pa3hcm/rigid-heddle-loom/print/pawl.stl

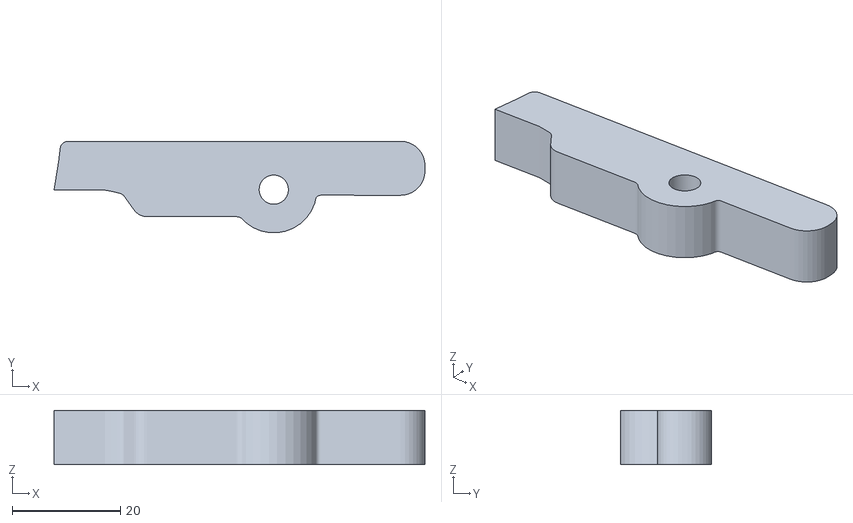
[picture p9: CAD file, 2026-11-07]
print/pawl.stl
68.7 x 16.9 x 10.0
