pa3hcm/rigid-heddle-loom/print/ratchet_front.stl

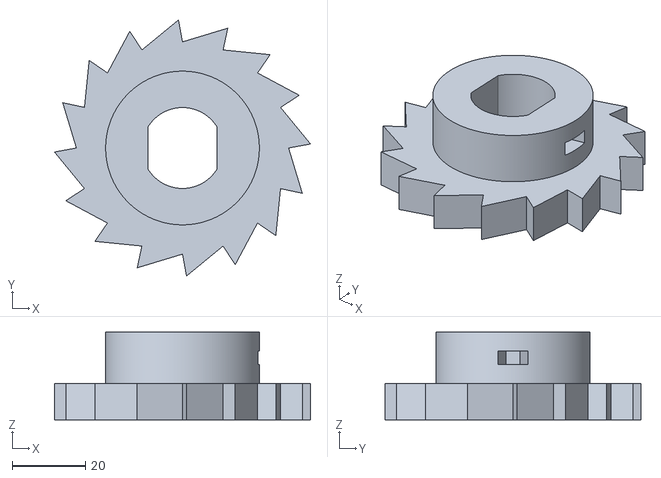
[picture p10: CAD file, 2026-11-05]
print/ratchet_front.stl
70.0 x 70.0 x 24.0
