pa3hcm/rigid-heddle-loom/print/filing_jig.stl

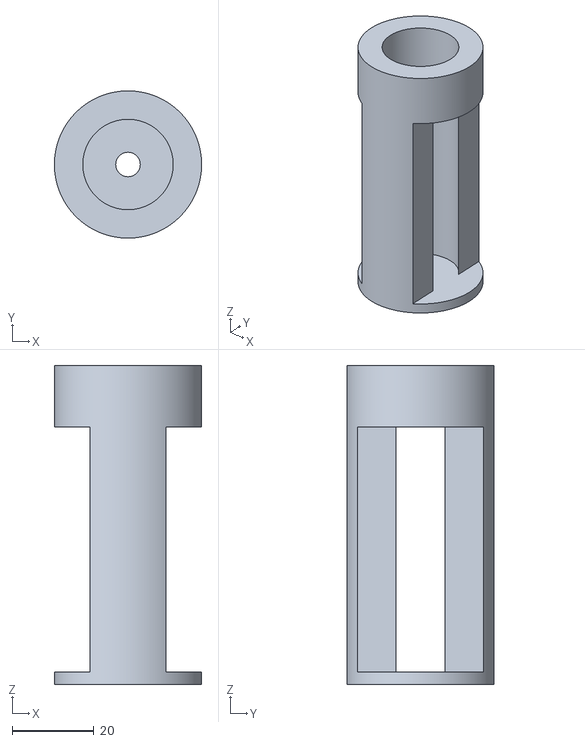
[picture p11: CAD file, 2026-11-05]
print/filing_jig.stl
36.0 x 36.0 x 78.0
