pa3hcm/rigid-heddle-loom/print/collar.stl

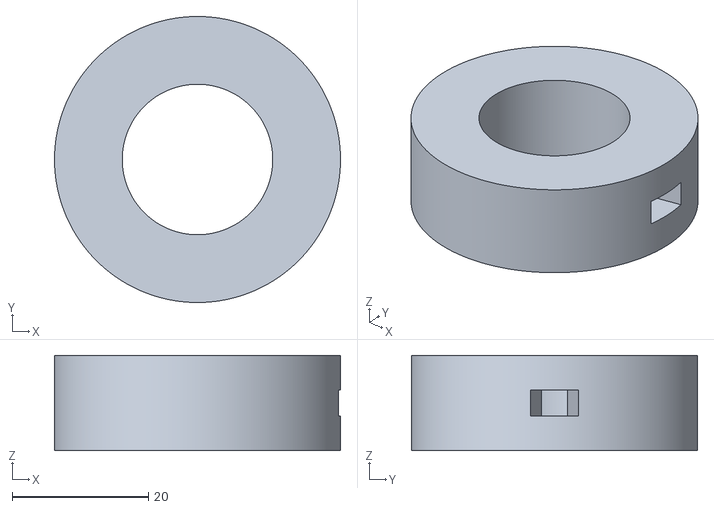
[picture p12: CAD file, 2026-11-05]
print/collar.stl
42.0 x 42.0 x 14.0
