pa3hcm/rigid-heddle-loom/print/knob.stl

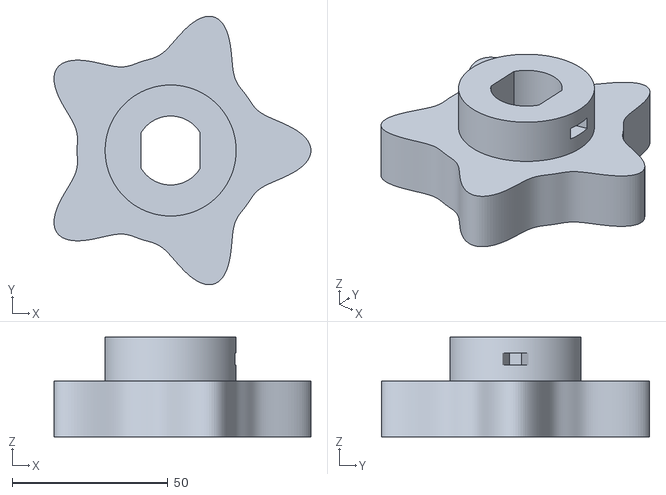
[picture p13: CAD file, 2026-11-05]
print/knob.stl
82.4 x 86.1 x 32.0
