pa3hcm/rigid-heddle-loom/print/loom_print.scad

// 3D-printed parts for the rigid heddle loom.
// Open in OpenSCAD, choose 'part' in the Customizer, F6 (render) and export as STL.
// Print settings: PETG or PLA, 0.2 mm layers, 4 walls, 40 % infill.
// You can also make print-ready STLs without OpenSCAD with generate_stl.py (same dimensions).

/* [Choice] */
part = "all"; // [all, ratchet_front, ratchet_back, pawl, knob, collar, filing_jig]

/* [Dimensions] */
dowel_d       = 21.7;  // diameter of the roller dowel (measured; nominal 22 mm)
clearance     = 0.4;   // extra bore for print tolerance
flat_distance = 18.5;  // distance between the two filed flats on the shaft
flat_length   = 60.0;  // length of the flats from the end of the shaft
screw_hole    = 3.8;   // locking hole for a 3.5 x 25 wood screw
teeth         = 16;
r_tip         = 35;    // outer radius of the ratchet wheel
r_root        = 29;    // root radius of the teeth
wheel_t       = 10;    // thickness of ratchet wheel = thickness of pawl
hub_d         = 42;
hub_l         = 14;
pawl_length   = 41;    // distance from pivot to pawl tip
pawl_hole     = 5.4;   // M5 pivot bolt
knob_d        = 90;
knob_t        = 18;
jig_d         = 36;    // outer diameter of the filing jig

$fn = 96;
bore = dowel_d + clearance;

module hub(l) {
    // hub with one radial locking hole in the +x direction (centred on a flat of the double-D bore)
    difference() {
        cylinder(d = hub_d, h = l);
        translate([0, 0, l / 2]) rotate([0, 90, 0]) cylinder(d = screw_hole, h = hub_d, $fn = 24);
    }
}

module double_d(h) {
    // bore for the filed shaft: round, with two flats perpendicular to x
    intersection() {
        cylinder(d = bore, h = h);
        translate([-(flat_distance + clearance) / 2, -bore, 0]) cube([flat_distance + clearance, 2 * bore, h]);
    }
}

module ratchet() {
    step = 360 / teeth;
    difference() {
        union() {
            linear_extrude(wheel_t) polygon([
                for (i = [0 : teeth - 1]) each [
                    [r_root * cos(i * step), r_root * sin(i * step)],
                    [r_tip * cos((i + 0.92) * step), r_tip * sin((i + 0.92) * step)]
                ]
            ]);
            translate([0, 0, wheel_t - 0.01]) hub(hub_l);
        }
        translate([0, 0, -1]) double_d(wheel_t + hub_l + 2);
    }
}

module pawl() {
    // pivot at the origin, tip at (-pawl_length, 0), release tab to the right, flat top.
    // The tip fits the tooth space: its face is parallel to the steep tooth flank and its underside
    // follows the ramp of the next tooth, so it drops fully into the tooth. Everything else is
    // rounded. The outline is generated by pawl_outline() in generate_stl.py (pawl length 41,
    // 0.4 mm clearance); regenerate it there if you change the teeth or the pivot position.
    difference() {
        linear_extrude(wheel_t) polygon([
            [28.00, 4.46], [27.93, 5.24], [27.73, 6.00], [27.40, 6.71], [26.95, 7.35], [26.39, 7.90],
            [25.75, 8.35], [25.04, 8.69], [24.28, 8.89], [23.50, 8.96], [-38.07, 8.96], [-38.34, 8.93],
            [-38.61, 8.86], [-38.85, 8.74], [-39.07, 8.58], [-39.26, 8.38], [-39.41, 8.15], [-39.51, 7.89],
            [-39.56, 7.63], [-39.81, 5.41], [-40.70, -0.11], [-40.02, 0.06], [-38.99, 0.18], [-37.95, 0.26],
            [-36.89, 0.31], [-35.81, 0.31], [-34.72, 0.28], [-33.62, 0.20], [-32.51, 0.09], [-31.39, -0.07],
            [-30.27, -0.27], [-29.13, -0.51], [-28.51, -0.67], [-28.27, -0.75], [-28.05, -0.88], [-27.86, -1.04],
            [-27.69, -1.23], [-25.90, -3.74], [-25.52, -4.17], [-25.08, -4.53], [-24.57, -4.79], [-24.02, -4.95],
            [-23.46, -5.00], [-6.94, -5.00], [-6.62, -5.03], [-6.30, -5.13], [-6.01, -5.29], [-5.76, -5.50],
            [-5.16, -6.11], [-3.88, -7.00], [-2.45, -7.62], [-0.93, -7.95], [0.62, -7.98], [2.16, -7.70],
            [3.61, -7.14], [4.92, -6.31], [6.05, -5.24], [6.95, -3.97], [7.58, -2.55], [7.78, -1.72],
            [7.83, -1.56], [7.91, -1.41], [8.02, -1.28], [8.15, -1.18], [8.30, -1.10], [8.47, -1.05],
            [8.63, -1.03], [23.50, -1.04], [24.28, -0.97], [25.04, -0.77], [25.75, -0.44], [26.39, 0.01],
            [26.95, 0.57], [27.40, 1.21], [27.73, 1.92], [27.93, 2.68], [28.00, 3.46]
        ]);
        translate([0, 0, -1]) cylinder(d = pawl_hole, h = wheel_t + 2);
    }
}

module knob() {
    lobes = 5;
    difference() {
        union() {
            linear_extrude(knob_t) offset(r = 6) offset(delta = -6) union() {
                circle(d = knob_d * 0.55);
                for (i = [0 : lobes - 1]) rotate(i * 360 / lobes)
                    translate([knob_d / 2 - 12, 0]) circle(d = 24);
                for (i = [0 : lobes - 1]) rotate(i * 360 / lobes)
                    hull() { circle(d = 18); translate([knob_d / 2 - 12, 0]) circle(d = 18); }
            }
            translate([0, 0, knob_t - 0.01]) hub(hub_l);
        }
        translate([0, 0, -1]) double_d(knob_t + hub_l + 2);
    }
}

module collar() {
    difference() {
        hub(hub_l);
        translate([0, 0, -1]) cylinder(d = bore, h = hub_l + 2);
    }
}

module filing_jig() {
    // sleeve over the shaft with a stop at the bottom; file until the shaft is level with the window edges
    base = 3;
    difference() {
        cylinder(d = jig_d, h = base + flat_length + 15);
        translate([0, 0, base]) cylinder(d = bore, h = flat_length + 16);
        translate([0, 0, -1]) cylinder(d = 6, h = base + 2);
        for (s = [-1, 1]) translate([s > 0 ? flat_distance / 2 : -flat_distance / 2 - jig_d / 2, -jig_d, base])
            cube([jig_d / 2, 2 * jig_d, flat_length]);
    }
}

// front (cloth roller) and back (warp roller) are mirror images: the rollers pull back in opposite directions
if (part == "ratchet_back") ratchet();
else if (part == "ratchet_front") mirror([0, 1, 0]) ratchet();
else if (part == "pawl") pawl();
else if (part == "knob") knob();
else if (part == "collar") collar();
else if (part == "filing_jig") filing_jig();
else {
    // print plate with all parts for one loom (2 rollers)
    translate([0, 0, 0]) mirror([0, 1, 0]) ratchet();   // front
    translate([80, 0, 0]) ratchet();                     // back
    for (i = [0, 1]) translate([i * 100 + 10, 95, 0]) knob();
    for (i = [0, 1]) translate([i * 75 + 210, 0, 0]) pawl();
    for (i = [0, 1]) translate([i * 50 + 210, 40, 0]) collar();
    translate([230, 100, 0]) filing_jig();
}
