pa3hcm/rigid-heddle-loom/(list of files, cad)

Other CAD files:
print/ratchet_back.stl
