pa3hcm/rigid-heddle-loom/(commit log)

2026-11-05 Rigid heddle loom: laser-cut and 3D-printed design
    Parametric 40 cm rigid heddle loom for a 600 x 400 mm laser cutter and a 3D
    printer, with a heddle for Lojan heddle segments, heddle blocks for two
    heddles, renders, STLs and manuals in English and Dutch.
    [collar.stl, filing_jig.stl, knob.stl, loom_print.scad, pawl.stl, ratchet_back.stl, ratchet_front.stl]
2026-11-07 Symmetric heddle blocks and a pawl that fits the ratchet teeth
    Heddle blocks: symmetric profile in the order down 1, neutral 1, up 1,
    up 2, neutral 2, down 2, with a lip at each end; 173 mm long instead of
    185 mm, same bolt holes.
    Pawl: the tip is calculated from the tooth shape and pivot position, with
    its face parallel to the steep flank and its underside along the ramp of
    the next tooth, so it drops 5.5 of 6 mm into the tooth instead of resting
    on the ramp. Flat top and rounded shapes elsewhere. The render now draws
    the real pawl outline.
    [loom_print.scad, pawl.stl]
